furkankarakaya/Forward-Converter/Components/Sipariş Listesi2.xlsx

Sheet: Sayfa1
Digikey Part No | Description | Digikey Link | Adet | Price | Total Price
493-15215-ND | CAP ALUM 220UF 20% 35V RADIAL | https://www.digikey.com/product-detail/en/nichicon/UHD1V221MPD6/493-15215-ND/2598112 | 10 | 0.328 | 3.28
495-5080-ND | FERRITE CORE TOROID 2.88UH N87 | https://www.digikey.com/products/en?keywords=B64290L0647X087%20 | 1 | 2.55 | 2.55
LT1952EGN-1#PBF-ND | IC REG CTRLR FWRD CONV 16SSOP | https://www.digikey.com/product-detail/en/linear-technology-analog-devices/LT1952EGN-1-PBF/LT1952EGN-1-PBF-ND/960984 | 2 | 6.79 | 13.58
BZG05C18-M3-08GICT-ND | DIODE ZENER 18V 1.25W DO214AC | https://www.digikey.com/product-detail/en/vishay-semiconductor-diodes-division/BZG05C18-M3-08/BZG05C18-M3-08GICT-ND/8555059 | 3 | 0.41 | 1.23
LTC3900ES8#PBF-ND | IC DRIVER RECT SYNC CONV 8SOIC | https://www.digikey.com/product-detail/en/linear-technology-analog-devices/LTC3900ES8-PBF/LTC3900ES8-PBF-ND/962810 | 2 | 5.13 | 10.26
PS2801-1ACT-ND | OPTOISOLATOR 2.5KV TRANS 4-SSOP | https://www.digikey.com/product-detail/en/cel/PS2801-1-F3-A/PS2801-1ACT-ND/770724 | 2 | 0.94 | 1.88
553-2107-ND | PULSE XFMR 1:1:1 300UH | https://www.digikey.com/products/en/transformers/pulse-transformers/166?k=P0926 | 1 | 3.3 | 3.3
TPH2900ENHL1QCT-ND | MOSFET N-CH 200V 33A SOP8 | https://www.digikey.com/product-detail/en/toshiba-semiconductor-and-storage/TPH2900ENHL1Q/TPH2900ENHL1QCT-ND/5456291 | 3 | 2.66 | 7.98
HAT2266H-EL-ECT-ND | MOSFET N-CH 60V 30A LFPAK | https://www.digikey.com/product-detail/en/renesas-electronics-america/HAT2266H-EL-E/HAT2266H-EL-ECT-ND/9169580 | 4 | 2.42 | 9.68
LM340SX-12/NOPBCT-ND | IC REG LIN 12V 1A DDPAK/TO263-3 | https://www.digikey.com/product-detail/en/texas-instruments/LM340SX-12-NOPB/LM340SX-12-NOPBCT-ND/3526960 | 2 | 1.85 | 3.7
 |  |  |  |  | 57.44
 |  |  |  |  |  | 402.608448

Sheet: Sheet1
Digikey Part No | Description | Digikey Link | Adet | Price | Total Price
P.024AUCT-ND | RES 0.024 OHM 1% 1W 1206 | https://www.digikey.com/product-detail/en/panasonic-electronic-components/ERJ-8BWFR024V/P.024AUCT-ND/1711691 | 1 | 0.74
