furkankarakaya/Forward-Converter/LT/Draft2.asc

C1: cap; 10p
C2: cap; 4.7n
C3: cap; 1µ
C4: cap; 33n
C6: cap; 2.2nF
Q1: pnp; BC856B
R1: res; 200k
R2: res; 8.2k
R3: res; 330
R4: res; 22k
R5: res; 1.2k
R6: res; 220
R7: res; 99Meg
R8: res; 27.2k
R9: res; 33k
U1: LT4430
U2: PS2801
U3: UniversalOpamp2
V1: voltage; 11.5
V2: voltage; 7.5
V3: voltage; ""; AC 1
V4: voltage; 1.23
V5: voltage; 10
V6: voltage; -10
Named nets: COM, 0, Vref
.ac dec 10 1 1Meg
