furkankarakaya/Forward-Converter/LT/Draft1.asc

L1: ind2; 690µ; Rser=13m
L2: ind2; 46.4µ; Rser=7m
L3: ind2; 72.5µ; Rser=10m
L4: ind2; 290µ; Rser=16m
R1: res; 1k
V1: voltage; PULSE(47.9 48.1 0 {1/120k-2e-9} 1e-9 1e-9 {1/120k})
Named nets: 0
K1 L1 L2 1
K2 L1 L3 1
K3 L1 L4 1
K4 L2 L3 1
K5 L2 L4 1
K6 L3 L4 1
.tran 1000u
