furkankarakaya/Forward-Converter/(commit log)

2018-12-05 sipariş listesi güncellendi.
    [Sipariş Listesi.xlsx]
2018-12-07 New order list.
    [Sipariş Listesi.xlsx, Sipariş Listesi2.xlsx]
2018-12-21 simulations are going well
    [Sipariş Listesi2.xlsx]
2018-12-28 Supply circuits are implemented. Feedback loop is under design.
2019-01-07 Simulations and schematic design are completed. Layout design is started.
    [Sipariş Listesi2.xlsx]
